nrmayer/STM32H7A3RGT6_Devboard/STM32H7A3RGT6_Devboard.kicad_pcb

## KiCad design STM32H7A3RGT6_Devboard.kicad_pcb (2026-10-09)

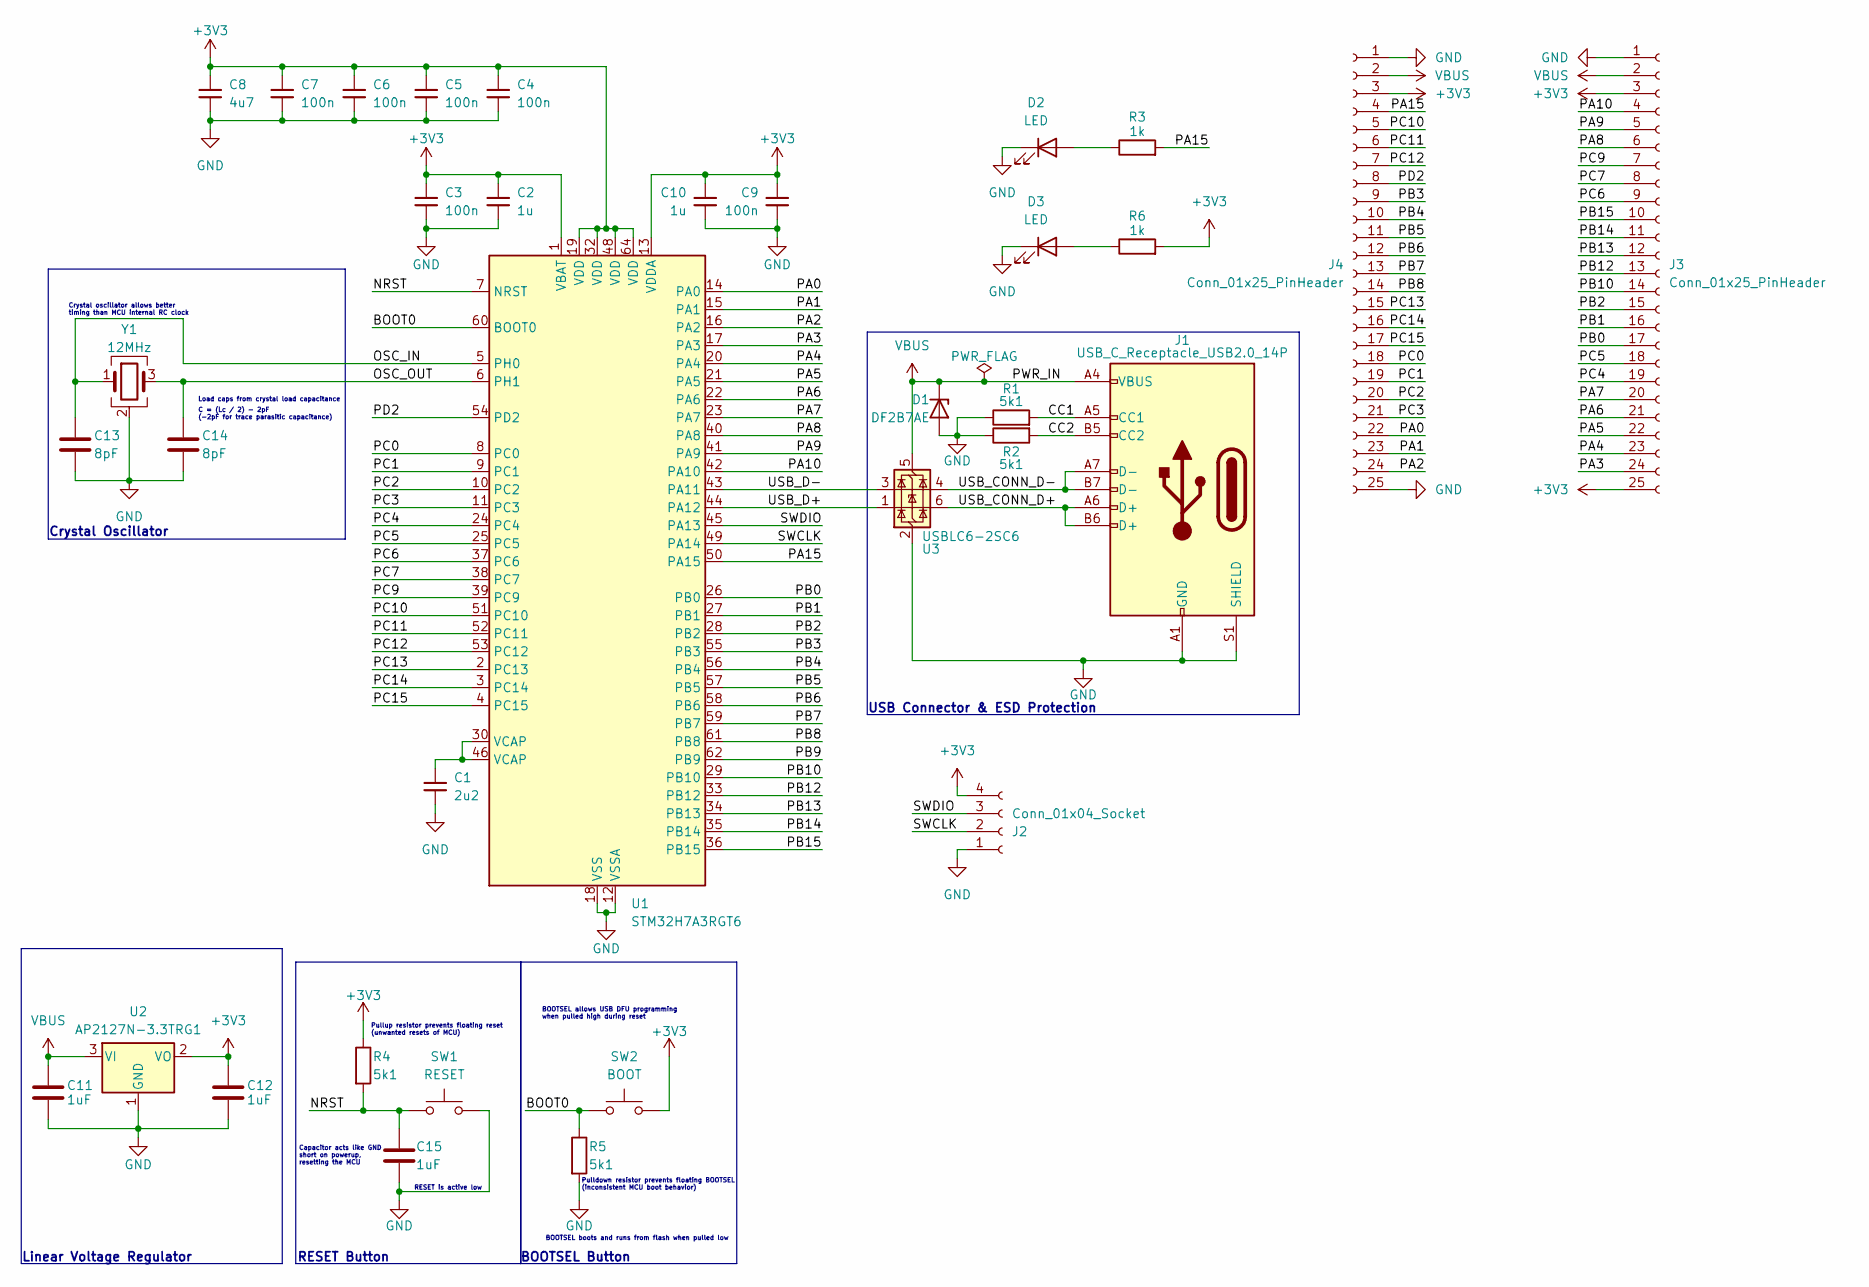
[picture p1: schematic STM32H7A3RGT6_Devboard.kicad_sch]

Parts:
C1: 2u2; C_0402_1005Metric_Pad0.74x0.62mm_HandSolder
C2, C10: 1u; C_0402_1005Metric_Pad0.74x0.62mm_HandSolder
C3, C4, C5, C6, C7, C9: 100n; C_0402_1005Metric_Pad0.74x0.62mm_HandSolder
C8: 4u7; C_0603_1608Metric
C11, C12: 1uF; C_0402_1005Metric_Pad0.74x0.62mm_HandSolder
C13, C14: 8pF; C_0402_1005Metric_Pad0.74x0.62mm_HandSolder
C15: 1uF; C_0603_1608Metric_Pad1.08x0.95mm_HandSolder
D1: DF2B7AE; D_SOD-523
D2, D3: LED; LED_0603_1608Metric
J1: USB_C_Receptacle_USB2.0_14P; USB_C_Receptacle_Molex_217179-0001
J2: Conn_01x04_Socket; PinHeader_1x04_P2.54mm_Vertical
J3, J4: Conn_01x25_PinHeader; PinHeader_1x25_P2.54mm_Vertical
R1, R2, R4, R5: 5k1; R_0603_1608Metric
R3, R6: 1k; R_0603_1608Metric_Pad0.98x0.95mm_HandSolder
SW1: RESET; SW_Push_1P1T-SH_NO_CK_KMR2xxG
SW2: BOOT; SW_Push_1P1T-SH_NO_CK_KMR2xxG
U1: STM32H7A3RGT6; LQFP-64_10x10mm_P0.5mm
U2: AP2127N-3.3TRG1; SOT-23
U3: USBLC6-2SC6; SOT-23-6
Y1: 12MHz; Crystal_SMD_2016-4Pin_2.0x1.6mm

Connections:
+3V3: C2.1, C3.1, C4.1, C5.1, C6.1, C7.1, C8.1, C9.1, C10.1, C12.1, J2.4, J3.3, J3.25, J4.3, R4.1, R6.2, SW2.2, U1.1 (VBAT), U1.13 (VDDA), U1.19 (VDD), U1.32 (VDD), U1.48 (VDD), U1.64 (VDD), U2.2 (VO)
/BOOT0: R5.1, SW2.1, U1.60 (BOOT0)
/CC1: J1.A5 (CC1), R1.2
/CC2: J1.B5 (CC2), R2.2
/NRST: C15.1, R4.2, SW1.1, U1.7 (NRST)
/OSC_IN: C13.1, U1.5 (PH0), Y1.1
/OSC_OUT: C14.1, U1.6 (PH1), Y1.3
/PA0: J4.22, U1.14 (PA0)
/PA1: J4.23, U1.15 (PA1)
/PA2: J4.24, U1.16 (PA2)
/PA3: J3.24, U1.17 (PA3)
/PA4: J3.23, U1.20 (PA4)
/PA5: J3.22, U1.21 (PA5)
/PA6: J3.21, U1.22 (PA6)
/PA7: J3.20, U1.23 (PA7)
/PA8: J3.6, U1.40 (PA8)
/PA9: J3.5, U1.41 (PA9)
/PA10: J3.4, U1.42 (PA10)
/PA15: J4.4, R3.2, U1.50 (PA15)
/PB0: J3.17, U1.26 (PB0)
/PB1: J3.16, U1.27 (PB1)
/PB2: J3.15, U1.28 (PB2)
/PB3: J4.9, U1.55 (PB3)
/PB4: J4.10, U1.56 (PB4)
/PB5: J4.11, U1.57 (PB5)
/PB6: J4.12, U1.58 (PB6)
/PB7: J4.13, U1.59 (PB7)
/PB8: J4.14, U1.61 (PB8)
/PB9: U1.62 (PB9)
/PB10: J3.14, U1.29 (PB10)
/PB12: J3.13, U1.33 (PB12)
/PB13: J3.12, U1.34 (PB13)
/PB14: J3.11, U1.35 (PB14)
/PB15: J3.10, U1.36 (PB15)
/PC0: J4.18, U1.8 (PC0)
/PC1: J4.19, U1.9 (PC1)
/PC2: J4.20, U1.10 (PC2)
/PC3: J4.21, U1.11 (PC3)
/PC4: J3.19, U1.24 (PC4)
/PC5: J3.18, U1.25 (PC5)
/PC6: J3.9, U1.37 (PC6)
/PC7: J3.8, U1.38 (PC7)
/PC9: J3.7, U1.39 (PC9)
/PC10: J4.5, U1.51 (PC10)
/PC11: J4.6, U1.52 (PC11)
/PC12: J4.7, U1.53 (PC12)
/PC13: J4.15, U1.2 (PC13)
/PC14: J4.16, U1.3 (PC14)
/PC15: J4.17, U1.4 (PC15)
/PD2: J4.8, U1.54 (PD2)
/SWCLK: J2.2, U1.49 (PA14)
/SWDIO: J2.3, U1.45 (PA13)
/USB_CONN_D+: J1.A6 (D+), J1.B6 (D+), U3.6 (I/O1)
/USB_CONN_D-: J1.A7 (D-), J1.B7 (D-), U3.4 (I/O2)
/USB_D+: U1.44 (PA12), U3.1 (I/O1)
/USB_D-: U1.43 (PA11), U3.3 (I/O2)
GND: C1.2, C2.2, C3.2, C4.2, C5.2, C6.2, C7.2, C8.2, C9.2, C10.2, C11.2, C12.2, C13.2, C14.2, C15.2, D1.2 (A), D2.1 (K), D3.1 (K), J1.A1 (GND), J1.A12 (GND), J1.B1 (GND), J1.B12 (GND), J1.S1 (SHIELD), J2.1, J3.1, J4.1, J4.25, R1.1, R2.1, R5.2, SW1.2, U1.12 (VSSA), U1.18 (VSS), U1.31 (VSS), U1.47 (VSS), U1.63 (VSS), U2.1 (GND), U3.2 (GND), Y1.2 (G), Y1.4 (G)
unnamed: C1.1, U1.30 (VCAP), U1.46 (VCAP)
unnamed: D2.2 (A), R3.1
unnamed: D3.2 (A), R6.1
VBUS: C11.1, D1.1 (K), J1.A4 (VBUS), J1.A9 (VBUS), J1.B4 (VBUS), J1.B9 (VBUS), J3.2, J4.2, U2.3 (VI), U3.5 (VBUS)

Notes on the sheet:
Linear Voltage Regulator
BOOTSEL allows USB DFU programming when pulled high during reset
Load caps from crystal load capacitance
USB Connector & ESD Protection
RESET Button
Capacitor acts like GND short on powerup, resetting the MCU
Pulldown resistor prevents floating BOOTSEL (inconsistent MCU boot behavior)
Crystal Oscillator
C = (Lc / 2) - 2pF (-2pF for trace parasitic capacitance)
BOOTSEL Button
Pullup resistor prevents floating reset (unwanted resets of MCU)
BOOTSEL boots and runs from flash when pulled low
RESET is active low
Crystal oscillator allows better timing than MCU internal RC clock

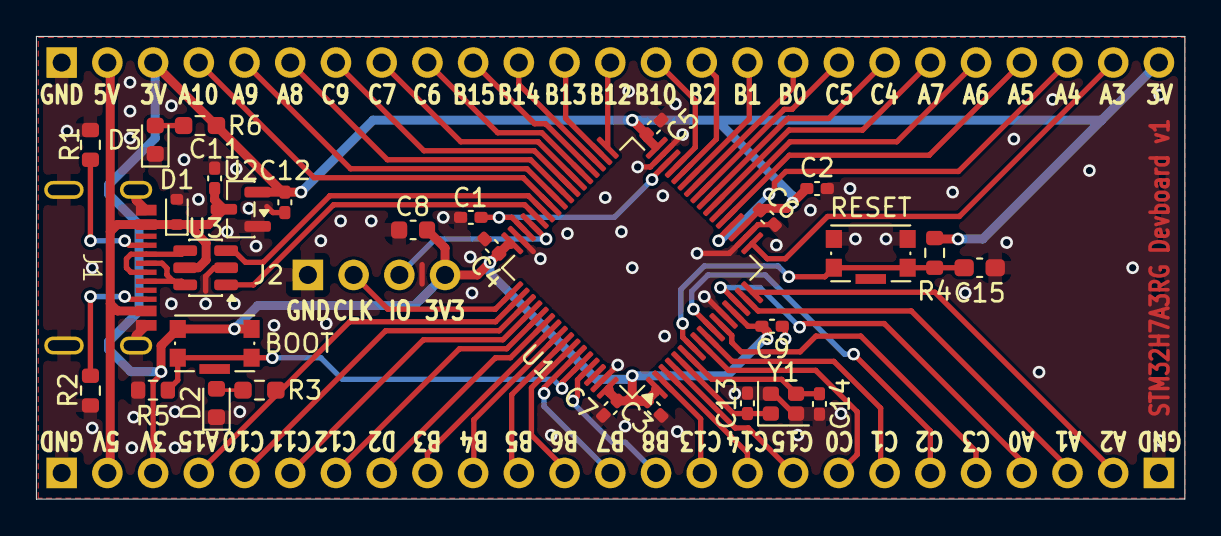
[picture p2: board STM32H7A3RGT6_Devboard.kicad_pcb from above]

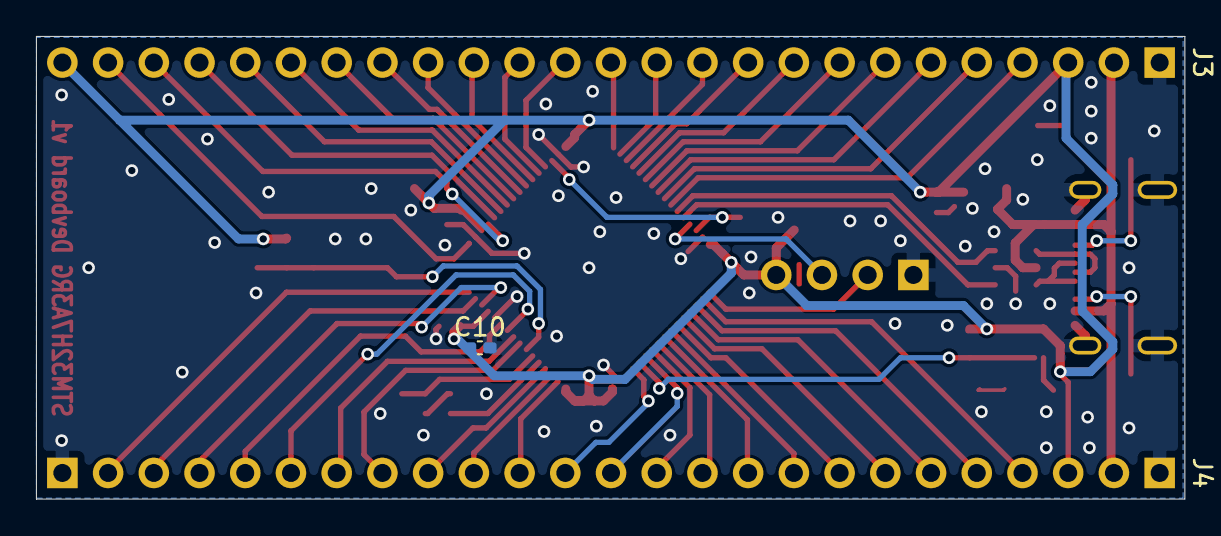
[picture p3: board STM32H7A3RGT6_Devboard.kicad_pcb from below]

Board: 2 copper layers, 63.8 x 25.7 mm, 34 parts (3 on the bottom side), 60 nets.
