nrmayer/STM32H7A3RGT6_Devboard/(commit log)

2026-10-08 MCU + Decoupling caps
    [STM32H7A3RGT6_Devboard.kicad_pcb, STM32H7A3RGT6_Devboard.kicad_sch]
2026-10-08 First full draft
    [STM32H7A3RGT6_Devboard.kicad_pcb, STM32H7A3RGT6_Devboard.kicad_sch]
2026-10-08 appease DRC checker
    [STM32H7A3RGT6_Devboard.kicad_pcb]
2026-10-09 Fix more DRC check errors
    [STM32H7A3RGT6_Devboard.kicad_pcb]
2026-10-09 Silkscreen and more vias
    [STM32H7A3RGT6_Devboard-B_Cu.gbr, STM32H7A3RGT6_Devboard-B_Mask.gbr, STM32H7A3RGT6_Devboard-B_Paste.gbr, STM32H7A3RGT6_Devboard-B_Silkscreen.gbr, STM32H7A3RGT6_Devboard-Edge_Cuts.gbr, STM32H7A3RGT6_Devboard-F_Cu.gbr, STM32H7A3RGT6_Devboard-F_Mask.gbr, STM32H7A3RGT6_Devboard-F_Paste.gbr]
